eTextile/soundKnit/docs/docs/Codeislaw©Jeanchristophe_Lett_crop.jpg

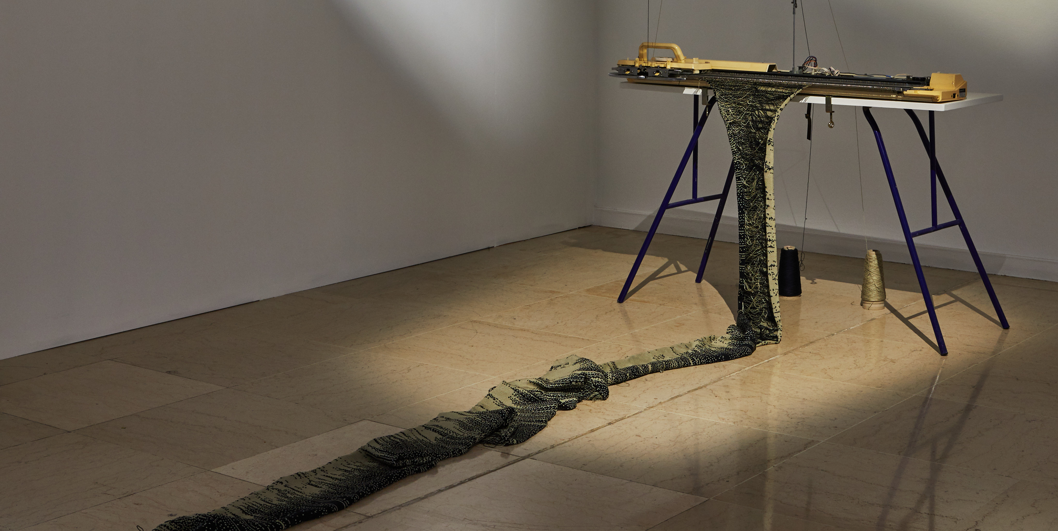
docs/docs/Codeislaw©Jeanchristophe_Lett_crop.jpg
