eTextile/soundKnit/docs/docs/soundKnit_01.png

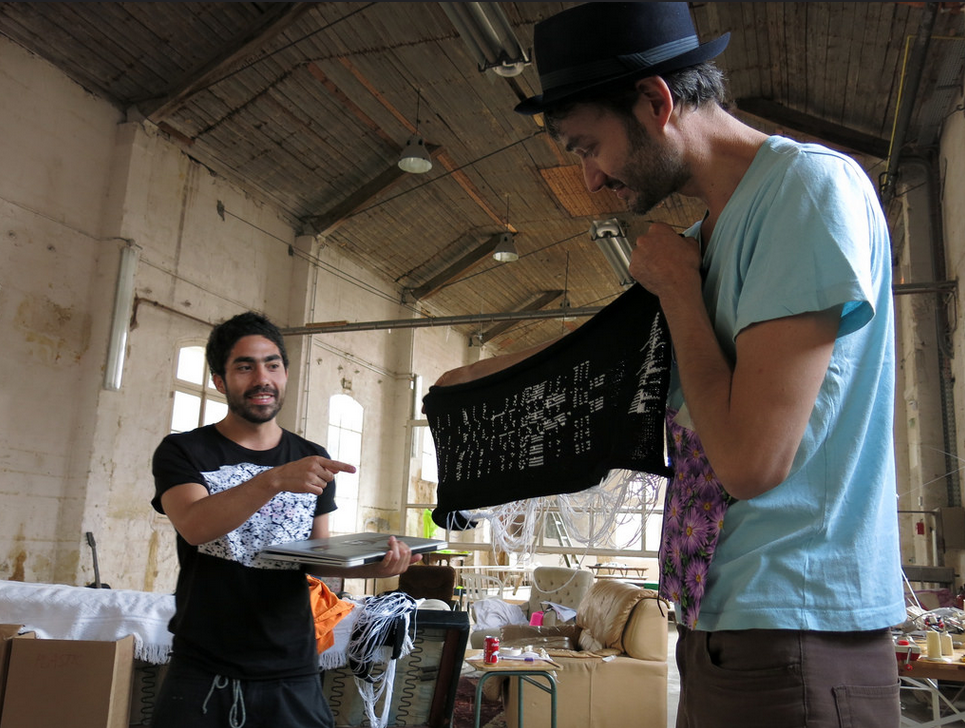
docs/docs/soundKnit_01.png
