eTextile/soundKnit/docs/docs/soundKnit_AYAB_00.jpg

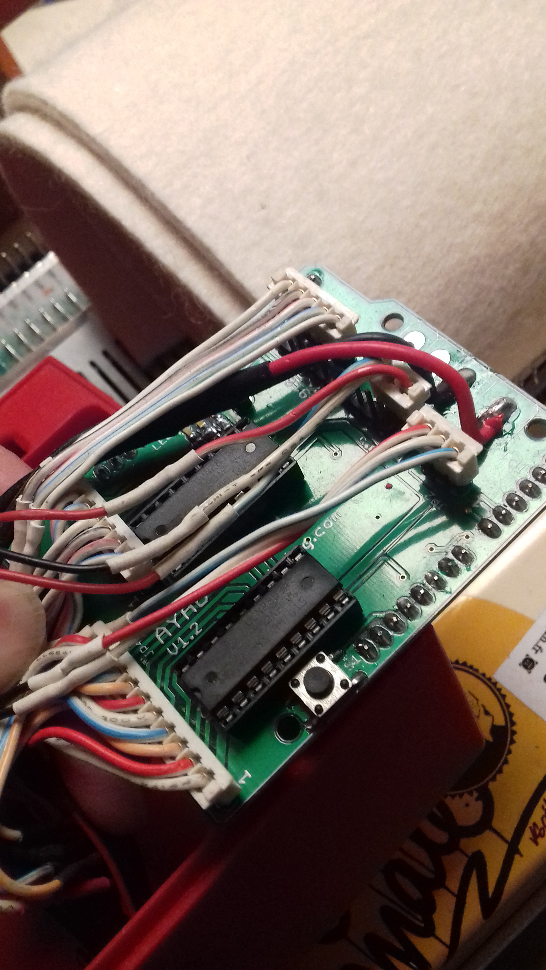
docs/docs/soundKnit_AYAB_00.jpg
