eTextile/soundKnit/docs/docs/soundKnit_AYAB_01.jpg

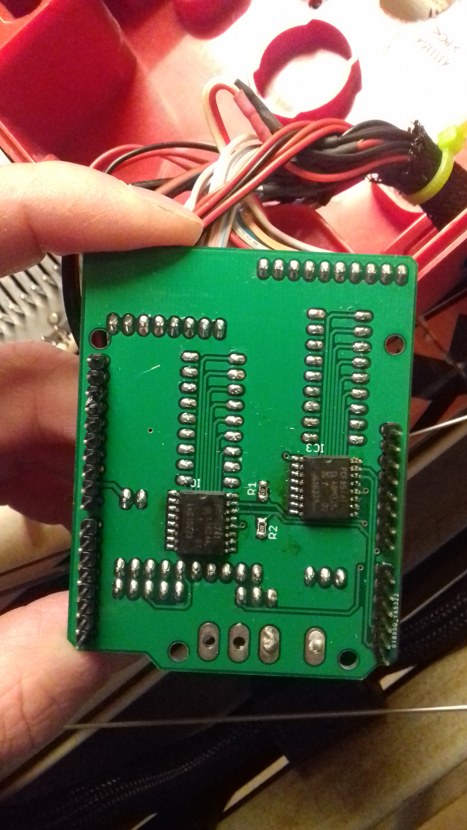
docs/docs/soundKnit_AYAB_01.jpg
