eTextile/soundKnit/docs/docs/soundKnit_AYAB_02.jpg

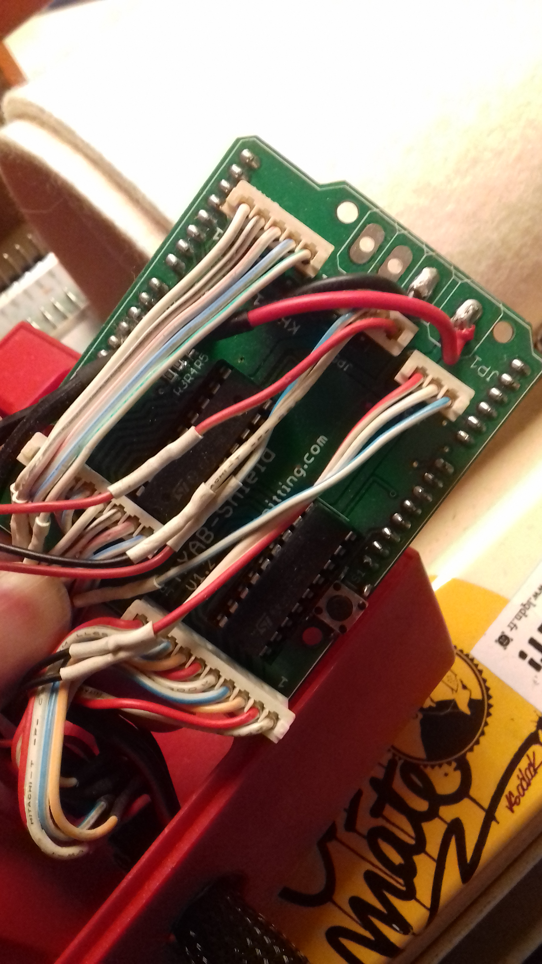
docs/docs/soundKnit_AYAB_02.jpg
