eTextile/soundKnit/Software/Processing/pictures/interdit.png

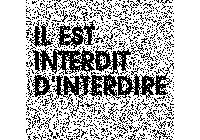
Software/Processing/pictures/interdit.png
