eTextile/soundKnit/Software/Processing/pictures/Pauline.png

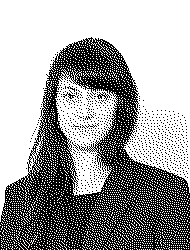
Software/Processing/pictures/Pauline.png
