eTextile/soundKnit/Software/Processing/pictures/petit_jabron.png

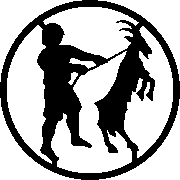
Software/Processing/pictures/petit_jabron.png
