eTextile/soundKnit/(list of files, drawings)

Other design files:
Hardware/ayab-hardware/Shieldv2x/layout/ayab_rs.pcb
