eTextile/soundKnit/Hardware/ayab-hardware/Shieldv1x/10_ayab-arduino/through_hole/arduino_shield.brd

## EAGLE design Hardware/ayab-hardware/Shieldv1x/10_ayab-arduino/through_hole/arduino_shield.brd (2020-02-04)

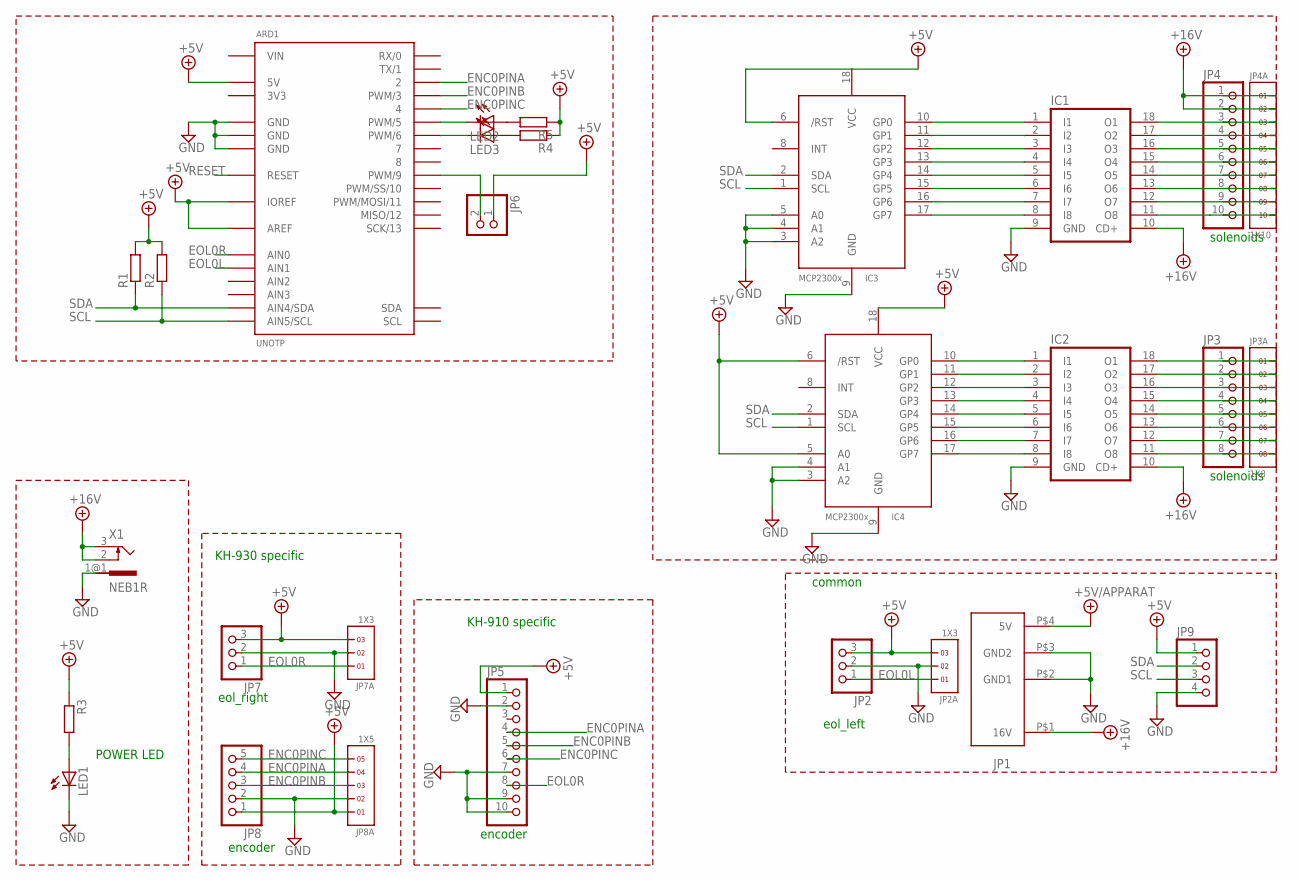
[picture p10: schematic arduino_shield.sch]

Parts:
ARD1: UNOTP
IC1, IC2: ULN2803A; DIL18
IC3, IC4: MCP2300X/P; DIL18
JP1: POWERCON; AYAB_POW
JP2, JP7: PINHD-1X3; 1X03
JP2A, JP7A: 1X3
JP3: PINHD-1X8; 1X08
JP3A: 1X8
JP4, JP5: PINHD-1X10; 1X10
JP4A: 1X10
JP6: PINHD-1X2; 1X02
JP8: PINHD-1X5; 1X05
JP8A: 1X5
JP9: PINHD-1X4; 1X04
LED1, LED2, LED3: LED3MM
R1, R2, R3, R4, R5: R-EU_0207/2V; 0207/2V
X1: NEB1R

Connections:
3V3: ARD1.3V3
+5V: ARD1.5V, ARD1.AREF, ARD1.IOREF, IC3.6 (/RST), IC3.18 (VCC), IC4.5 (A0), IC4.6 (/RST), IC4.18 (VCC), JP2.3, JP2A.3, JP5.1, JP6.1, JP7.3, JP7A.3, JP8.1, JP8A.1, JP9.1, R1.2, R2.2, R3.1, R4.1, R5.1
+5V/1: JP1.P$4 (5V)
+15V: IC1.10 (CD+), IC2.10 (CD+), JP1.P$1 (16V), JP4.1, JP4.2, JP4A.1, JP4A.2, X1.2, X1.3
ENC0PINA: ARD1.2, JP5.4, JP8.4, JP8A.4
ENC0PINB: ARD1.3 (PWM/3), JP5.5, JP8.3, JP8A.3
ENC0PINC: ARD1.4, JP5.6, JP8.5, JP8A.5
EOL0L: ARD1.AIN1, JP2.1, JP2A.1
EOL0R: ARD1.AIN0, JP5.8, JP7.1, JP7A.1
GND: ARD1.GND@1 (GND), ARD1.GND@2 (GND), ARD1.GND@3 (GND), IC1.9 (GND), IC2.9 (GND), IC3.3 (A2), IC3.4 (A1), IC3.5 (A0), IC3.9 (GND), IC4.3 (A2), IC4.4 (A1), IC4.9 (GND), JP1.P$2 (GND1), JP1.P$3 (GND2), JP2.2, JP2A.2, JP5.2, JP5.7, JP5.9, JP5.10, JP7.2, JP7A.2, JP8.2, JP8A.2, JP9.4, LED1.K (C), X1.1@1 (1)
unnamed: IC2.1 (I1), IC4.10 (GP0)
unnamed: IC1.1 (I1), IC3.10 (GP0)
unnamed: IC1.2 (I2), IC3.11 (GP1)
unnamed: IC1.3 (I3), IC3.12 (GP2)
unnamed: IC1.4 (I4), IC3.13 (GP3)
unnamed: IC1.5 (I5), IC3.14 (GP4)
unnamed: IC1.6 (I6), IC3.15 (GP5)
unnamed: IC1.7 (I7), IC3.16 (GP6)
unnamed: IC1.8 (I8), IC3.17 (GP7)
unnamed: IC2.2 (I2), IC4.11 (GP1)
unnamed: IC2.3 (I3), IC4.12 (GP2)
unnamed: IC2.4 (I4), IC4.13 (GP3)
unnamed: IC2.5 (I5), IC4.14 (GP4)
unnamed: IC2.6 (I6), IC4.15 (GP5)
unnamed: IC2.7 (I7), IC4.16 (GP6)
unnamed: IC2.8 (I8), IC4.17 (GP7)
unnamed: IC2.18 (O1), JP3.1, JP3A.1
unnamed: IC2.17 (O2), JP3.2, JP3A.2
unnamed: IC2.16 (O3), JP3.3, JP3A.3
unnamed: IC2.15 (O4), JP3.4, JP3A.4
unnamed: IC2.14 (O5), JP3.5, JP3A.5
unnamed: IC2.13 (O6), JP3.6, JP3A.6
unnamed: IC2.12 (O7), JP3.7, JP3A.7
unnamed: IC2.11 (O8), JP3.8, JP3A.8
unnamed: IC1.11 (O8), JP4.10, JP4A.10
unnamed: IC1.12 (O7), JP4.9, JP4A.9
unnamed: IC1.13 (O6), JP4.8, JP4A.8
unnamed: IC1.14 (O5), JP4.7, JP4A.7
unnamed: IC1.15 (O4), JP4.6, JP4A.6
unnamed: IC1.16 (O3), JP4.5, JP4A.5
unnamed: IC1.17 (O2), JP4.4, JP4A.4
unnamed: IC1.18 (O1), JP4.3, JP4A.3
unnamed: LED1.A, R3.2
unnamed: ARD1.9 (PWM/9), JP6.2
unnamed: ARD1.6 (PWM/6), LED3.K (C)
unnamed: ARD1.5 (PWM/5), LED2.K (C)
unnamed: LED3.A, R4.2
unnamed: LED2.A, R5.2
RESET: ARD1.RST (RESET)
SCL: ARD1.AIN5 (AIN5/SCL), IC3.1 (SCL), IC4.1 (SCL), JP9.3, R2.1
SDA: ARD1.AIN4 (AIN4/SDA), IC3.2 (SDA), IC4.2 (SDA), JP9.2, R1.1
VIN: ARD1.VIN

Notes on the sheet:
eol_left
encoder
solenoids
POWER LED
eol_right
KH-930 specific
common
KH-910 specific

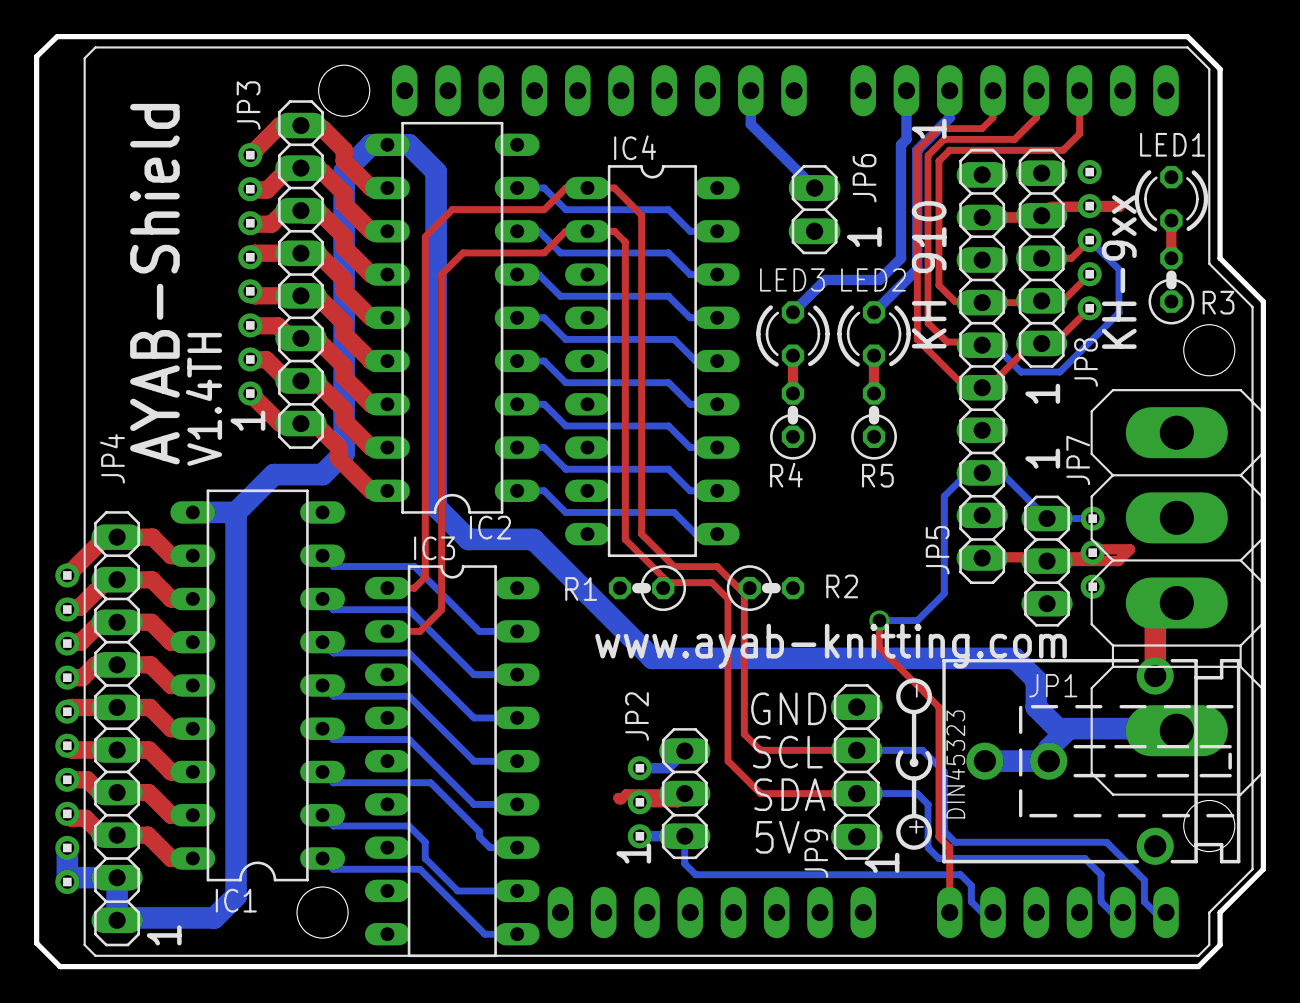
[picture p11: board Hardware/ayab-hardware/Shieldv1x/10_ayab-arduino/through_hole/arduino… from above]

Board: 2 copper layers, 72.0 x 54.6 mm, 29 parts (0 on the bottom side), 48 nets.

Other parts of the board:
U$2: V1.3TH; A4L-LOC
