eTextile/soundKnit/Hardware/ayab-hardware/Shieldv1x/10_ayab-arduino/smd/arduino_shield.brd

## EAGLE design Hardware/ayab-hardware/Shieldv1x/10_ayab-arduino/smd/arduino_shield.brd (2020-02-04)

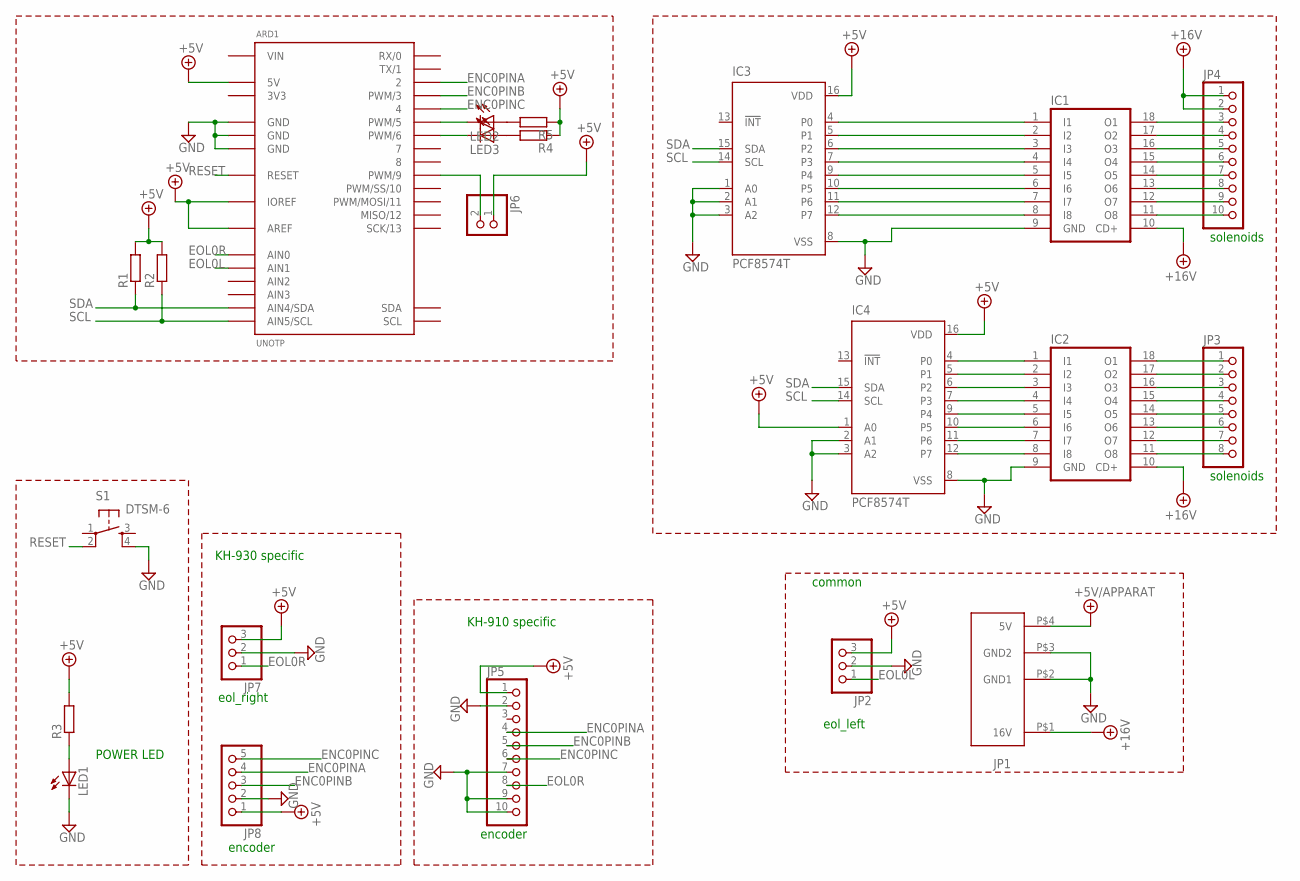
[picture p12: schematic arduino_shield.sch]

Parts:
ARD1: UNOTP
IC1, IC2: ULN2803A; DIL18
IC3, IC4: PCF8574T; SO16W
JP1: POWERCON; AYAB_POW
JP2, JP7: PINHD-1X3; 1X03
JP3: PINHD-1X8; 1X08
JP4, JP5: PINHD-1X10; 1X10
JP6: PINHD-1X2; 1X02
JP8: PINHD-1X5; 1X05
LED1, LED2, LED3: LEDCHIP-LED0805; CHIP-LED0805
R1, R2, R3, R4, R5: R-EU_R0805; R0805
S1: DTSM-6

Connections:
3V3: ARD1.3V3
+5V: ARD1.5V, ARD1.AREF, ARD1.IOREF, IC3.16 (VDD), IC4.1 (A0), IC4.16 (VDD), JP2.3, JP5.1, JP6.1, JP7.3, JP8.1, R1.2, R2.2, R3.2, R4.1, R5.1
+5V/1: JP1.P$4 (5V)
+15V: IC1.10 (CD+), IC2.10 (CD+), JP1.P$1 (16V), JP4.1, JP4.2
ENC0PINA: ARD1.2, JP5.4, JP8.4
ENC0PINB: ARD1.3 (PWM/3), JP5.5, JP8.3
ENC0PINC: ARD1.4, JP5.6, JP8.5
EOL0L: ARD1.AIN1, JP2.1
EOL0R: ARD1.AIN0, JP5.8, JP7.1
GND: ARD1.GND@1 (GND), ARD1.GND@2 (GND), ARD1.GND@3 (GND), IC1.9 (GND), IC2.9 (GND), IC3.1 (A0), IC3.2 (A1), IC3.3 (A2), IC3.8 (VSS), IC4.2 (A1), IC4.3 (A2), IC4.8 (VSS), JP1.P$2 (GND1), JP1.P$3 (GND2), JP2.2, JP5.2, JP5.7, JP5.9, JP5.10, JP7.2, JP8.2, LED1.C, S1.4
unnamed: IC2.1 (I1), IC4.4 (P0)
unnamed: IC1.1 (I1), IC3.4 (P0)
unnamed: IC1.2 (I2), IC3.5 (P1)
unnamed: IC1.3 (I3), IC3.6 (P2)
unnamed: IC1.4 (I4), IC3.7 (P3)
unnamed: IC1.5 (I5), IC3.9 (P4)
unnamed: IC1.6 (I6), IC3.10 (P5)
unnamed: IC1.7 (I7), IC3.11 (P6)
unnamed: IC1.8 (I8), IC3.12 (P7)
unnamed: IC2.2 (I2), IC4.5 (P1)
unnamed: IC2.3 (I3), IC4.6 (P2)
unnamed: IC2.4 (I4), IC4.7 (P3)
unnamed: IC2.5 (I5), IC4.9 (P4)
unnamed: IC2.6 (I6), IC4.10 (P5)
unnamed: IC2.7 (I7), IC4.11 (P6)
unnamed: IC2.8 (I8), IC4.12 (P7)
unnamed: IC2.18 (O1), JP3.1
unnamed: IC2.17 (O2), JP3.2
unnamed: IC2.16 (O3), JP3.3
unnamed: IC2.15 (O4), JP3.4
unnamed: IC2.14 (O5), JP3.5
unnamed: IC2.13 (O6), JP3.6
unnamed: IC2.12 (O7), JP3.7
unnamed: IC2.11 (O8), JP3.8
unnamed: IC1.11 (O8), JP4.10
unnamed: IC1.12 (O7), JP4.9
unnamed: IC1.13 (O6), JP4.8
unnamed: IC1.14 (O5), JP4.7
unnamed: IC1.15 (O4), JP4.6
unnamed: IC1.16 (O3), JP4.5
unnamed: IC1.17 (O2), JP4.4
unnamed: IC1.18 (O1), JP4.3
unnamed: LED1.A, R3.1
unnamed: ARD1.9 (PWM/9), JP6.2
unnamed: ARD1.6 (PWM/6), LED3.C
unnamed: ARD1.5 (PWM/5), LED2.C
unnamed: LED3.A, R4.2
unnamed: LED2.A, R5.2
RESET: ARD1.RST (RESET), S1.2
SCL: ARD1.AIN5 (AIN5/SCL), IC3.14 (SCL), IC4.14 (SCL), R2.1
SDA: ARD1.AIN4 (AIN4/SDA), IC3.15 (SDA), IC4.15 (SDA), R1.1
VIN: ARD1.VIN

Notes on the sheet:
eol_left
encoder
solenoids
POWER LED
eol_right
KH-930 specific
common
KH-910 specific

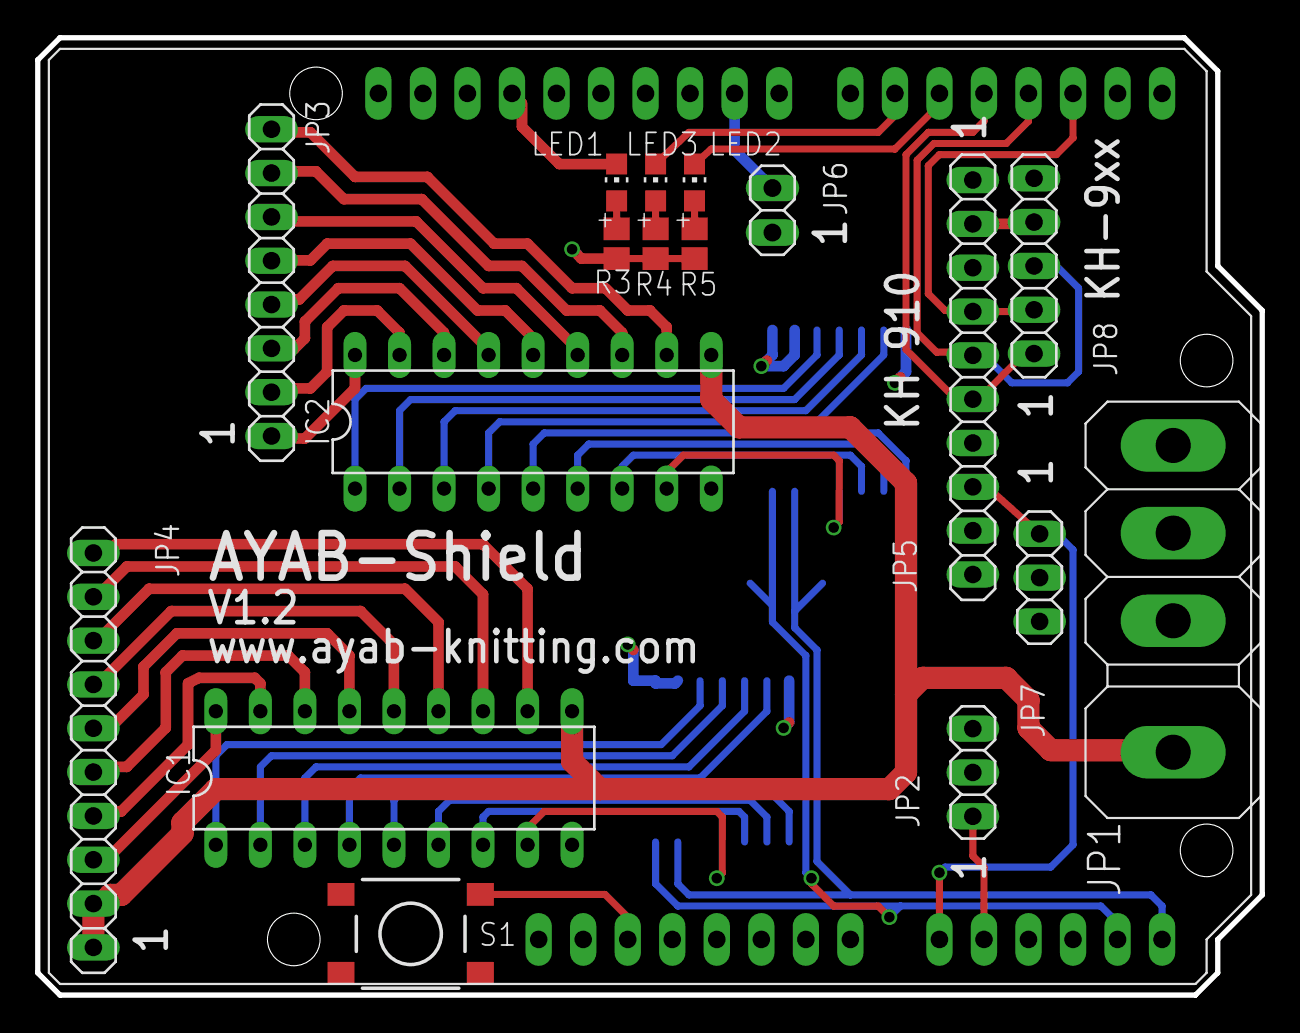
[picture p13: board Hardware/ayab-hardware/Shieldv1x/10_ayab-arduino/smd/arduino_shield.b… from above]

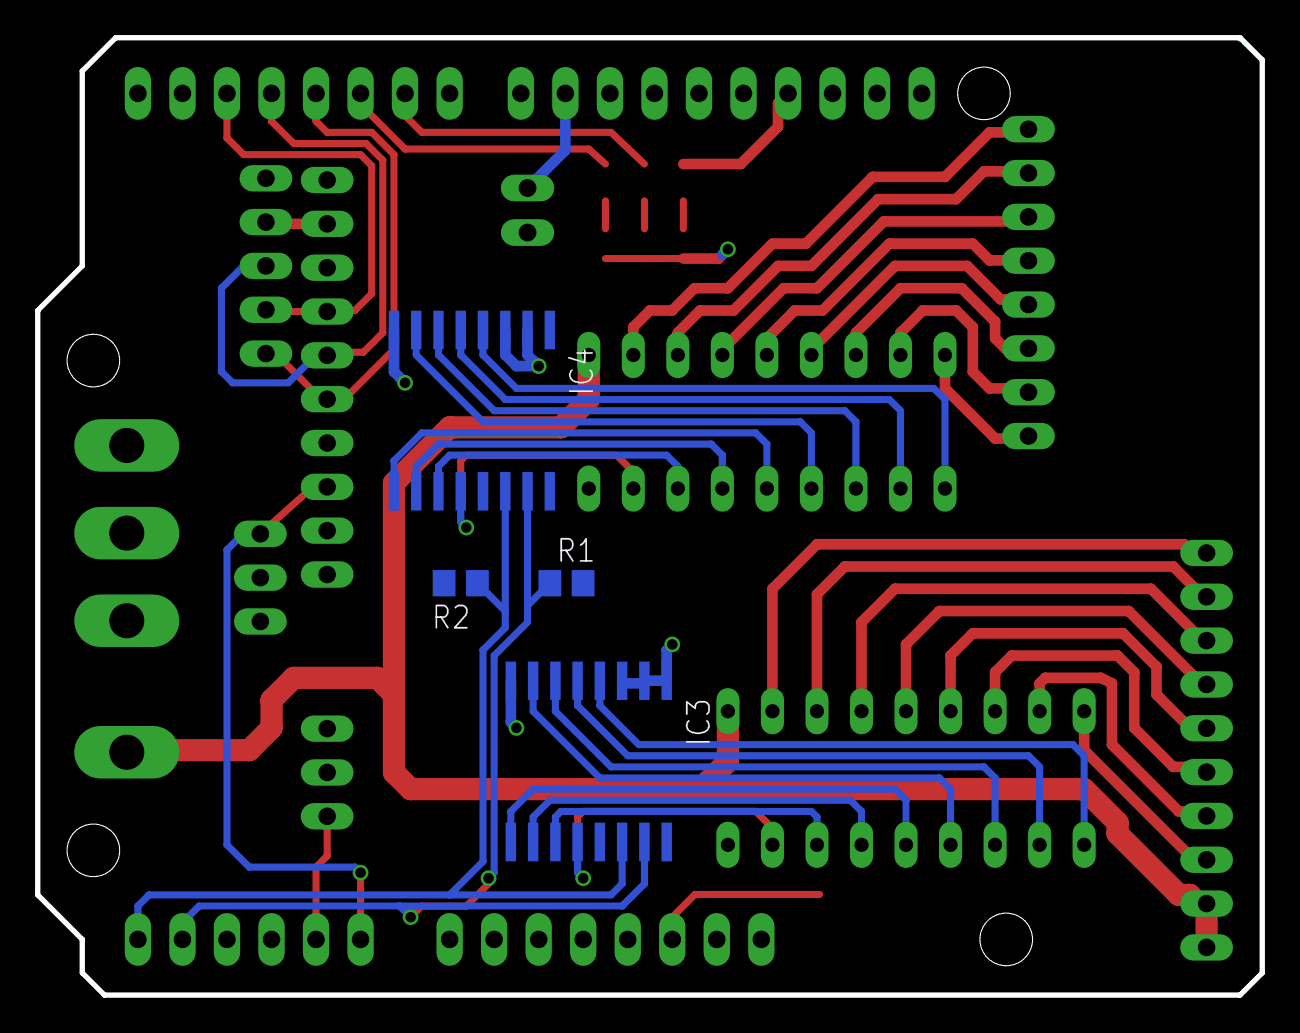
[picture p14: board Hardware/ayab-hardware/Shieldv1x/10_ayab-arduino/smd/arduino_shield.b… from below]

Board: 2 copper layers, 69.9 x 54.6 mm, 23 parts (4 on the bottom side), 49 nets.

Other parts of the board:
U$1: A4L-LOC
