eTextile/soundKnit/(commit log)

2022-12-13 Remove printf (not working with Arduino uno
    [soundKnit_V01.ino]
2022-12-14 testin new encoder sensing tech
2025-10-04 Working prototype
